giljerard/tia-sscs-pico-2021/schem/png/comp_cap.png

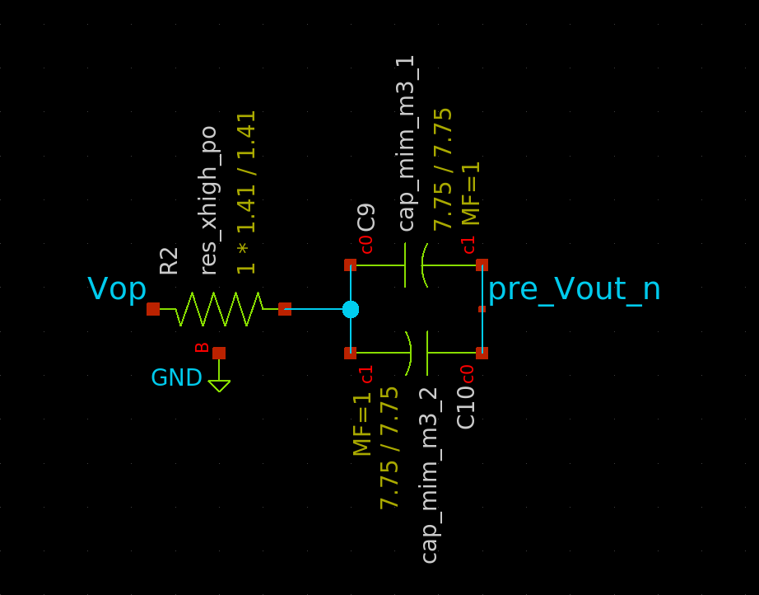
schem/png/comp_cap.png
