giljerard/tia-sscs-pico-2021/schem/png/Flattened-SSCS0.pdf

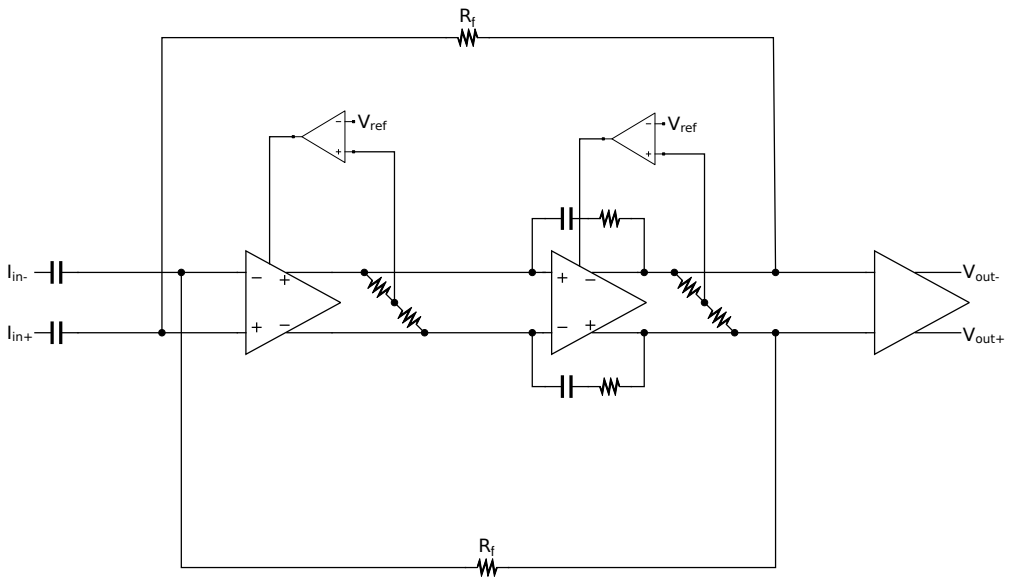
[picture p20: page 1]
+ Iin-; Rf Rf Vre; Vref f Iin+; Vout-
