giljerard/tia-sscs-pico-2021/pex/cmfb_pex.spice

* NGSPICE file created from cmfb.ext - technology: sky130A

.subckt cmfb_half VDD GND Vout res Vb3 Vin diode
X0 Vout Vin res GND sky130_fd_pr__nfet_01v8 ad=0p pd=0u as=0p ps=0u w=1e+07u l=200000u
X1 GND Vb3 res GND sky130_fd_pr__nfet_01v8 ad=0p pd=0u as=0p ps=0u w=1.3e+07u l=500000u
X2 Vout diode VDD VDD sky130_fd_pr__pfet_01v8 ad=0p pd=0u as=0p ps=0u w=1.05e+07u l=200000u
X3 res Vin Vout GND sky130_fd_pr__nfet_01v8 ad=0p pd=0u as=0p ps=0u w=1e+07u l=200000u
X4 res Vin Vout GND sky130_fd_pr__nfet_01v8 ad=0p pd=0u as=0p ps=0u w=1e+07u l=200000u
X5 Vout Vin res GND sky130_fd_pr__nfet_01v8 ad=0p pd=0u as=0p ps=0u w=1e+07u l=200000u
X6 GND Vb3 res GND sky130_fd_pr__nfet_01v8 ad=0p pd=0u as=0p ps=0u w=1.3e+07u l=500000u
X7 VDD diode Vout VDD sky130_fd_pr__pfet_01v8 ad=0p pd=0u as=0p ps=0u w=1.05e+07u l=200000u
X8 Vout Vin res GND sky130_fd_pr__nfet_01v8 ad=0p pd=0u as=0p ps=0u w=1e+07u l=200000u
X9 res Vin Vout GND sky130_fd_pr__nfet_01v8 ad=0p pd=0u as=0p ps=0u w=1e+07u l=200000u
X10 Vout diode VDD VDD sky130_fd_pr__pfet_01v8 ad=0p pd=0u as=0p ps=0u w=1.05e+07u l=200000u
X11 res Vin Vout GND sky130_fd_pr__nfet_01v8 ad=0p pd=0u as=0p ps=0u w=1e+07u l=200000u
X12 res Vin Vout GND sky130_fd_pr__nfet_01v8 ad=0p pd=0u as=0p ps=0u w=1e+07u l=200000u
X13 res Vb3 GND GND sky130_fd_pr__nfet_01v8 ad=0p pd=0u as=0p ps=0u w=1.3e+07u l=500000u
X14 res Vin Vout GND sky130_fd_pr__nfet_01v8 ad=0p pd=0u as=0p ps=0u w=1e+07u l=200000u
X15 Vout Vin res GND sky130_fd_pr__nfet_01v8 ad=0p pd=0u as=0p ps=0u w=1e+07u l=200000u
X16 VDD diode Vout VDD sky130_fd_pr__pfet_01v8 ad=0p pd=0u as=0p ps=0u w=1.05e+07u l=200000u
X17 res Vb3 GND GND sky130_fd_pr__nfet_01v8 ad=0p pd=0u as=0p ps=0u w=1.3e+07u l=500000u
X18 Vout Vin res GND sky130_fd_pr__nfet_01v8 ad=0p pd=0u as=0p ps=0u w=1e+07u l=200000u
X19 res Vin Vout GND sky130_fd_pr__nfet_01v8 ad=0p pd=0u as=0p ps=0u w=1e+07u l=200000u
X20 res Vin Vout GND sky130_fd_pr__nfet_01v8 ad=0p pd=0u as=0p ps=0u w=1e+07u l=200000u
X21 Vout Vin res GND sky130_fd_pr__nfet_01v8 ad=0p pd=0u as=0p ps=0u w=1e+07u l=200000u
X22 GND Vb3 res GND sky130_fd_pr__nfet_01v8 ad=0p pd=0u as=0p ps=0u w=1.3e+07u l=500000u
X23 Vout Vin res GND sky130_fd_pr__nfet_01v8 ad=0p pd=0u as=0p ps=0u w=1e+07u l=200000u
C0 Vout VDD 6.84fF
C1 res Vout 25.99fF
C2 Vb3 GND 3.81fF
C3 Vin GND 8.94fF
C4 res GND 7.55fF
C5 VDD GND 6.58fF
.ends

.subckt cmfb Vb3 Vref Vcm GND VDD Vcmfb
Xcmfb_half_1 VDD GND Vcmfb cmfb_half_1/res Vb3 Vref cmfb_half_0/Vout cmfb_half
Xcmfb_half_0 VDD GND cmfb_half_0/Vout cmfb_half_0/res Vb3 Vcm cmfb_half_0/Vout cmfb_half
X0 cmfb_half_1/res cmfb_half_0/res GND sky130_fd_pr__res_xhigh_po w=1.41e+06u l=1.41e+06u
C0 VDD GND 13.26fF
C1 Vcm GND 8.94fF
C2 cmfb_half_0/res GND 9.75fF
C3 Vb3 GND 7.49fF
C4 Vref GND 8.94fF
C5 cmfb_half_1/res GND 8.48fF
C6 cmfb_half_0/Vout GND 6.87fF
.ends
