giljerard/tia-sscs-pico-2021/pex/sf_pex.spice

* NGSPICE file created from sf.ext - technology: sky130A

.subckt sf_nup GND g d s
X0 s g d GND sky130_fd_pr__nfet_01v8_lvt ad=0p pd=0u as=0p ps=0u w=2.5e+07u l=320000u
X1 s g d GND sky130_fd_pr__nfet_01v8_lvt ad=0p pd=0u as=0p ps=0u w=2.5e+07u l=320000u
X2 d g s GND sky130_fd_pr__nfet_01v8_lvt ad=0p pd=0u as=0p ps=0u w=2.5e+07u l=320000u
X3 s g d GND sky130_fd_pr__nfet_01v8_lvt ad=0p pd=0u as=0p ps=0u w=2.5e+07u l=320000u
X4 s g d GND sky130_fd_pr__nfet_01v8_lvt ad=0p pd=0u as=0p ps=0u w=2.5e+07u l=320000u
X5 d g s GND sky130_fd_pr__nfet_01v8_lvt ad=0p pd=0u as=0p ps=0u w=2.5e+07u l=320000u
X6 s g d GND sky130_fd_pr__nfet_01v8_lvt ad=0p pd=0u as=0p ps=0u w=2.5e+07u l=320000u
X7 s g d GND sky130_fd_pr__nfet_01v8_lvt ad=0p pd=0u as=0p ps=0u w=2.5e+07u l=320000u
X8 d g s GND sky130_fd_pr__nfet_01v8_lvt ad=0p pd=0u as=0p ps=0u w=2.5e+07u l=320000u
X9 s g d GND sky130_fd_pr__nfet_01v8_lvt ad=0p pd=0u as=0p ps=0u w=2.5e+07u l=320000u
X10 s g d GND sky130_fd_pr__nfet_01v8_lvt ad=0p pd=0u as=0p ps=0u w=2.5e+07u l=320000u
X11 d g s GND sky130_fd_pr__nfet_01v8_lvt ad=0p pd=0u as=0p ps=0u w=2.5e+07u l=320000u
X12 d g s GND sky130_fd_pr__nfet_01v8_lvt ad=0p pd=0u as=0p ps=0u w=2.5e+07u l=320000u
X13 s g d GND sky130_fd_pr__nfet_01v8_lvt ad=0p pd=0u as=0p ps=0u w=2.5e+07u l=320000u
X14 d g s GND sky130_fd_pr__nfet_01v8_lvt ad=0p pd=0u as=0p ps=0u w=2.5e+07u l=320000u
X15 d g s GND sky130_fd_pr__nfet_01v8_lvt ad=0p pd=0u as=0p ps=0u w=2.5e+07u l=320000u
X16 d g s GND sky130_fd_pr__nfet_01v8_lvt ad=0p pd=0u as=0p ps=0u w=2.5e+07u l=320000u
X17 s g d GND sky130_fd_pr__nfet_01v8_lvt ad=0p pd=0u as=0p ps=0u w=2.5e+07u l=320000u
X18 s g d GND sky130_fd_pr__nfet_01v8_lvt ad=0p pd=0u as=0p ps=0u w=2.5e+07u l=320000u
X19 s g d GND sky130_fd_pr__nfet_01v8_lvt ad=0p pd=0u as=0p ps=0u w=2.5e+07u l=320000u
X20 d g s GND sky130_fd_pr__nfet_01v8_lvt ad=0p pd=0u as=0p ps=0u w=2.5e+07u l=320000u
X21 d g s GND sky130_fd_pr__nfet_01v8_lvt ad=0p pd=0u as=0p ps=0u w=2.5e+07u l=320000u
X22 s g d GND sky130_fd_pr__nfet_01v8_lvt ad=0p pd=0u as=0p ps=0u w=2.5e+07u l=320000u
X23 d g s GND sky130_fd_pr__nfet_01v8_lvt ad=0p pd=0u as=0p ps=0u w=2.5e+07u l=320000u
X24 d g s GND sky130_fd_pr__nfet_01v8_lvt ad=0p pd=0u as=0p ps=0u w=2.5e+07u l=320000u
X25 d g s GND sky130_fd_pr__nfet_01v8_lvt ad=0p pd=0u as=0p ps=0u w=2.5e+07u l=320000u
C0 g s 3.79fF
C1 s d 77.94fF
C2 g d 3.64fF
C3 d GND 5.93fF
C4 g GND 17.45fF
C5 s GND 14.64fF
.ends

.subckt sf_ndown g d s
X0 d g s s sky130_fd_pr__nfet_01v8 ad=0p pd=0u as=0p ps=0u w=2.5e+07u l=450000u
X1 d g s s sky130_fd_pr__nfet_01v8 ad=0p pd=0u as=0p ps=0u w=2.5e+07u l=450000u
X2 d g s s sky130_fd_pr__nfet_01v8 ad=0p pd=0u as=0p ps=0u w=2.5e+07u l=450000u
X3 d g s s sky130_fd_pr__nfet_01v8 ad=0p pd=0u as=0p ps=0u w=2.5e+07u l=450000u
X4 s g d s sky130_fd_pr__nfet_01v8 ad=0p pd=0u as=0p ps=0u w=2.5e+07u l=450000u
X5 d g s s sky130_fd_pr__nfet_01v8 ad=0p pd=0u as=0p ps=0u w=2.5e+07u l=450000u
X6 d g s s sky130_fd_pr__nfet_01v8 ad=0p pd=0u as=0p ps=0u w=2.5e+07u l=450000u
X7 s g d s sky130_fd_pr__nfet_01v8 ad=0p pd=0u as=0p ps=0u w=2.5e+07u l=450000u
X8 s g d s sky130_fd_pr__nfet_01v8 ad=0p pd=0u as=0p ps=0u w=2.5e+07u l=450000u
X9 s g d s sky130_fd_pr__nfet_01v8 ad=0p pd=0u as=0p ps=0u w=2.5e+07u l=450000u
X10 d g s s sky130_fd_pr__nfet_01v8 ad=0p pd=0u as=0p ps=0u w=2.5e+07u l=450000u
X11 d g s s sky130_fd_pr__nfet_01v8 ad=0p pd=0u as=0p ps=0u w=2.5e+07u l=450000u
X12 s g d s sky130_fd_pr__nfet_01v8 ad=0p pd=0u as=0p ps=0u w=2.5e+07u l=450000u
X13 s g d s sky130_fd_pr__nfet_01v8 ad=0p pd=0u as=0p ps=0u w=2.5e+07u l=450000u
X14 s g d s sky130_fd_pr__nfet_01v8 ad=0p pd=0u as=0p ps=0u w=2.5e+07u l=450000u
X15 d g s s sky130_fd_pr__nfet_01v8 ad=0p pd=0u as=0p ps=0u w=2.5e+07u l=450000u
X16 d g s s sky130_fd_pr__nfet_01v8 ad=0p pd=0u as=0p ps=0u w=2.5e+07u l=450000u
X17 d g s s sky130_fd_pr__nfet_01v8 ad=0p pd=0u as=0p ps=0u w=2.5e+07u l=450000u
X18 s g d s sky130_fd_pr__nfet_01v8 ad=0p pd=0u as=0p ps=0u w=2.5e+07u l=450000u
X19 s g d s sky130_fd_pr__nfet_01v8 ad=0p pd=0u as=0p ps=0u w=2.5e+07u l=450000u
X20 d g s s sky130_fd_pr__nfet_01v8 ad=0p pd=0u as=0p ps=0u w=2.5e+07u l=450000u
X21 d g s s sky130_fd_pr__nfet_01v8 ad=0p pd=0u as=0p ps=0u w=2.5e+07u l=450000u
X22 s g d s sky130_fd_pr__nfet_01v8 ad=0p pd=0u as=0p ps=0u w=2.5e+07u l=450000u
X23 s g d s sky130_fd_pr__nfet_01v8 ad=0p pd=0u as=0p ps=0u w=2.5e+07u l=450000u
X24 s g d s sky130_fd_pr__nfet_01v8 ad=0p pd=0u as=0p ps=0u w=2.5e+07u l=450000u
X25 s g d s sky130_fd_pr__nfet_01v8 ad=0p pd=0u as=0p ps=0u w=2.5e+07u l=450000u
C0 g d 5.11fF
C1 d s 66.44fF
C2 g s 21.60fF
.ends

.subckt sf_half Vout g_u g_d d s
Xsf_nup_0 s g_u d Vout sf_nup
Xsf_ndown_0 g_d Vout s sf_ndown
C0 g_d s 21.61fF
C1 d s 5.94fF
C2 g_u s 17.46fF
C3 Vout s 81.55fF
.ends

.subckt sf VDD Vin_n Vin_p Vout_p Vout_n sf_2 GND VDD#1
Xsf_half_0 Vout_p Vin_p sf_2 VDD#1 GND sf_half
Xsf_half_1 Vout_n Vin_n sf_2 VDD GND sf_half
C0 VDD GND 5.93fF
C1 Vin_n GND 17.47fF
C2 Vout_n GND 81.21fF
C3 sf_2 GND 47.24fF
C4 VDD#1 GND 5.93fF
C5 Vin_p GND 17.46fF
C6 Vout_p GND 81.15fF
.ends
