giljerard/tia-sscs-pico-2021/sims/core_stability.spice

**.subckt flattened_core_stability
VDD_source net1 GND 1.8
Vmeas net1 VDD 0
XM90 net3 net3 GND GND sky130_fd_pr__nfet_01v8 L=.15 W=50 nf=1 ad='int((nf+1)/2) * W/nf * 0.29' as='int((nf+2)/2) * W/nf * 0.29'
+ pd='2*int((nf+1)/2) * (W/nf + 0.29)' ps='2*int((nf+2)/2) * (W/nf + 0.29)' nrd='0.29 / W' nrs='0.29 / W'
+ sa=0 sb=0 sd=0 mult=1 m=1 
XM91 net2 net2 VDD_test VDD_test sky130_fd_pr__pfet_01v8 L=0.16 W=16 nf=1 ad='int((nf+1)/2) * W/nf * 0.29'
+ as='int((nf+2)/2) * W/nf * 0.29' pd='2*int((nf+1)/2) * (W/nf + 0.29)' ps='2*int((nf+2)/2) * (W/nf + 0.29)'
+ nrd='0.29 / W' nrs='0.29 / W' sa=0 sb=0 sd=0 mult=1 m=1 
I0 net2 GND 300u
I1 VDD_test net3 1m
XM1 net5 Vb1 net6 net6 sky130_fd_pr__nfet_01v8 L=.5 W=710 nf=8 ad='int((nf+1)/2) * W/nf * 0.29' as='int((nf+2)/2) * W/nf * 0.29'
+ pd='2*int((nf+1)/2) * (W/nf + 0.29)' ps='2*int((nf+2)/2) * (W/nf + 0.29)' nrd='0.29 / W' nrs='0.29 / W'
+ sa=0 sb=0 sd=0 mult=1 m=1 
VDD_test_source net4 GND 1.8
Vmeas2 net4 VDD_test 0
XM2 Vop Vinn net5 GND sky130_fd_pr__nfet_01v8 L=0.15 W=150 nf=4 ad='int((nf+1)/2) * W/nf * 0.29' as='int((nf+2)/2) * W/nf * 0.29'
+ pd='2*int((nf+1)/2) * (W/nf + 0.29)' ps='2*int((nf+2)/2) * (W/nf + 0.29)' nrd='0.29 / W' nrs='0.29 / W'
+ sa=0 sb=0 sd=0 mult=1 m=1 
XM3 Von Vinp net5 GND sky130_fd_pr__nfet_01v8 L=0.15 W=150 nf=4 ad='int((nf+1)/2) * W/nf * 0.29' as='int((nf+2)/2) * W/nf * 0.29'
+ pd='2*int((nf+1)/2) * (W/nf + 0.29)' ps='2*int((nf+2)/2) * (W/nf + 0.29)' nrd='0.29 / W' nrs='0.29 / W'
+ sa=0 sb=0 sd=0 mult=1 m=1 
XM5 Von Vcmfb1 VDD VDD sky130_fd_pr__pfet_01v8 L=0.18 W=112 nf=5 ad='int((nf+1)/2) * W/nf * 0.29' as='int((nf+2)/2) * W/nf * 0.29'
+ pd='2*int((nf+1)/2) * (W/nf + 0.29)' ps='2*int((nf+2)/2) * (W/nf + 0.29)' nrd='0.29 / W' nrs='0.29 / W'
+ sa=0 sb=0 sd=0 mult=1 m=1 
XM4 Vop Vcmfb1 net31 VDD sky130_fd_pr__pfet_01v8 L=0.18 W=112 nf=5 ad='int((nf+1)/2) * W/nf * 0.29' as='int((nf+2)/2) * W/nf * 0.29'
+ pd='2*int((nf+1)/2) * (W/nf + 0.29)' ps='2*int((nf+2)/2) * (W/nf + 0.29)' nrd='0.29 / W' nrs='0.29 / W'
+ sa=0 sb=0 sd=0 mult=1 m=1 
Vb2_source Vb2 GND .75
Vmeas1 VDD net31 0
XM6 net7 Vb1 net8 net8 sky130_fd_pr__nfet_01v8 L=.5 W=710 nf=8 ad='int((nf+1)/2) * W/nf * 0.29' as='int((nf+2)/2) * W/nf * 0.29'
+ pd='2*int((nf+1)/2) * (W/nf + 0.29)' ps='2*int((nf+2)/2) * (W/nf + 0.29)' nrd='0.29 / W' nrs='0.29 / W'
+ sa=0 sb=0 sd=0 mult=1 m=1 
XM7 pre_Vout_p Von net7 GND sky130_fd_pr__nfet_01v8 L=0.15 W=150 nf=4 ad='int((nf+1)/2) * W/nf * 0.29'
+ as='int((nf+2)/2) * W/nf * 0.29' pd='2*int((nf+1)/2) * (W/nf + 0.29)' ps='2*int((nf+2)/2) * (W/nf + 0.29)'
+ nrd='0.29 / W' nrs='0.29 / W' sa=0 sb=0 sd=0 mult=1 m=1 
XM8 pre_Vout_n Vop net7 GND sky130_fd_pr__nfet_01v8 L=0.15 W=150 nf=4 ad='int((nf+1)/2) * W/nf * 0.29'
+ as='int((nf+2)/2) * W/nf * 0.29' pd='2*int((nf+1)/2) * (W/nf + 0.29)' ps='2*int((nf+2)/2) * (W/nf + 0.29)'
+ nrd='0.29 / W' nrs='0.29 / W' sa=0 sb=0 sd=0 mult=1 m=1 
XM9 pre_Vout_n Vcmfb2 VDD VDD sky130_fd_pr__pfet_01v8 L=0.18 W=112 nf=8 ad='int((nf+1)/2) * W/nf * 0.29'
+ as='int((nf+2)/2) * W/nf * 0.29' pd='2*int((nf+1)/2) * (W/nf + 0.29)' ps='2*int((nf+2)/2) * (W/nf + 0.29)'
+ nrd='0.29 / W' nrs='0.29 / W' sa=0 sb=0 sd=0 mult=1 m=1 
XM10 pre_Vout_p Vcmfb2 net32 VDD sky130_fd_pr__pfet_01v8 L=0.18 W=112 nf=8 ad='int((nf+1)/2) * W/nf * 0.29'
+ as='int((nf+2)/2) * W/nf * 0.29' pd='2*int((nf+1)/2) * (W/nf + 0.29)' ps='2*int((nf+2)/2) * (W/nf + 0.29)'
+ nrd='0.29 / W' nrs='0.29 / W' sa=0 sb=0 sd=0 mult=1 m=1 
Vmeas4 VDD net32 0
Vmeas5 net9 GND 0
VDD_dummy_source net10 GND 1.8
Vmeas6 net10 VDD_dummy 0
XR6 Vfbn pre_Vout_n GND sky130_fd_pr__res_xhigh_po_1p41 W=1.41 L=53 mult=1 m=1
XR1 pre_Vout_p Vfbp GND sky130_fd_pr__res_xhigh_po_1p41 W=1.41 L=53 mult=1 m=1
XM16 Vout_p Vb3 net11 net11 sky130_fd_pr__nfet_01v8 L=.45 W=650 nf=8 ad='int((nf+1)/2) * W/nf * 0.29'
+ as='int((nf+2)/2) * W/nf * 0.29' pd='2*int((nf+1)/2) * (W/nf + 0.29)' ps='2*int((nf+2)/2) * (W/nf + 0.29)'
+ nrd='0.29 / W' nrs='0.29 / W' sa=0 sb=0 sd=0 mult=1 m=1 
XM19 Vout_n Vb3 GND GND sky130_fd_pr__nfet_01v8 L=.45 W=650 nf=8 ad='int((nf+1)/2) * W/nf * 0.29' as='int((nf+2)/2) * W/nf * 0.29'
+ pd='2*int((nf+1)/2) * (W/nf + 0.29)' ps='2*int((nf+2)/2) * (W/nf + 0.29)' nrd='0.29 / W' nrs='0.29 / W'
+ sa=0 sb=0 sd=0 mult=1 m=1 
Vmeas8 net11 GND 0
XM17 VDD pre_Vout_p Vout_p GND sky130_fd_pr__nfet_01v8_lvt L=0.32 W=650 nf=8 ad='int((nf+1)/2) * W/nf * 0.29'
+ as='int((nf+2)/2) * W/nf * 0.29' pd='2*int((nf+1)/2) * (W/nf + 0.29)' ps='2*int((nf+2)/2) * (W/nf + 0.29)'
+ nrd='0.29 / W' nrs='0.29 / W' sa=0 sb=0 sd=0 mult=1 m=1 
XM18 VDD pre_Vout_n Vout_n GND sky130_fd_pr__nfet_01v8_lvt L=0.32 W=650 nf=8 ad='int((nf+1)/2) * W/nf * 0.29'
+ as='int((nf+2)/2) * W/nf * 0.29' pd='2*int((nf+1)/2) * (W/nf + 0.29)' ps='2*int((nf+2)/2) * (W/nf + 0.29)'
+ nrd='0.29 / W' nrs='0.29 / W' sa=0 sb=0 sd=0 mult=1 m=1 
C5 GND Vout_n 20p m=1
C6 GND Vout_p 20p m=1
Vmeas9 net8 GND 0
Vmeas10 net6 GND 0
XM24 Vop Vb2 net12 net12 sky130_fd_pr__pfet_01v8 L=0.18 W=448 nf=15 ad='int((nf+1)/2) * W/nf * 0.29'
+ as='int((nf+2)/2) * W/nf * 0.29' pd='2*int((nf+1)/2) * (W/nf + 0.29)' ps='2*int((nf+2)/2) * (W/nf + 0.29)'
+ nrd='0.29 / W' nrs='0.29 / W' sa=0 sb=0 sd=0 mult=1 m=1 
XM25 Von Vb2 VDD VDD sky130_fd_pr__pfet_01v8 L=0.18 W=448 nf=15 ad='int((nf+1)/2) * W/nf * 0.29' as='int((nf+2)/2) * W/nf * 0.29'
+ pd='2*int((nf+1)/2) * (W/nf + 0.29)' ps='2*int((nf+2)/2) * (W/nf + 0.29)' nrd='0.29 / W' nrs='0.29 / W'
+ sa=0 sb=0 sd=0 mult=1 m=1 
Vmeas12 VDD net12 0
XM27 net13 net13 net14 net14 sky130_fd_pr__nfet_01v8 L=.5 W=3.6 nf=1 ad='int((nf+1)/2) * W/nf * 0.29'
+ as='int((nf+2)/2) * W/nf * 0.29' pd='2*int((nf+1)/2) * (W/nf + 0.29)' ps='2*int((nf+2)/2) * (W/nf + 0.29)'
+ nrd='0.29 / W' nrs='0.29 / W' sa=0 sb=0 sd=0 mult=1 m=1 
Vmeas14 net14 GND 0
R9 VDD net13 26k ac=26k m=1
C2 net16 Von 250f m=1
C1 net15 Vop 250f m=1
XR3 Vcm2 pre_Vout_p GND sky130_fd_pr__res_xhigh_po_1p41 W=1.41 L=35 mult=1 m=1
XR5 pre_Vout_n Vcm2 GND sky130_fd_pr__res_xhigh_po_1p41 W=1.41 L=35 mult=1 m=1
XR4 pre_Vout_n net15 GND sky130_fd_pr__res_xhigh_po_1p41 W=1.41 L=1.41 mult=1 m=1
XR10 pre_Vout_p net16 GND sky130_fd_pr__res_xhigh_po_1p41 W=1.41 L=1.41 mult=1 m=1
XR2 net9 VDD_dummy GND sky130_fd_pr__res_xhigh_po_0p35 W=0.35 L=175 mult=5 m=5
XR11 Vb1 net13 GND sky130_fd_pr__res_xhigh_po_0p35 W=0.35 L=175 mult=1 m=1
C9 GND Vb1 1p m=1
XM28 net17 net17 net18 net18 sky130_fd_pr__nfet_01v8 L=.45 W=4 nf=1 ad='int((nf+1)/2) * W/nf * 0.29'
+ as='int((nf+2)/2) * W/nf * 0.29' pd='2*int((nf+1)/2) * (W/nf + 0.29)' ps='2*int((nf+2)/2) * (W/nf + 0.29)'
+ nrd='0.29 / W' nrs='0.29 / W' sa=0 sb=0 sd=0 mult=1 m=1 
Vmeas15 net18 GND 0
R13 VDD net17 26k ac=26k m=1
XR14 Vb3 net17 GND sky130_fd_pr__res_xhigh_po_0p35 W=0.35 L=175 mult=1 m=1
C10 GND Vb3 1p m=1
XM29 net19 net19 net20 net20 sky130_fd_pr__nfet_01v8 L=.5 W=10 nf=1 ad='int((nf+1)/2) * W/nf * 0.29'
+ as='int((nf+2)/2) * W/nf * 0.29' pd='2*int((nf+1)/2) * (W/nf + 0.29)' ps='2*int((nf+2)/2) * (W/nf + 0.29)'
+ nrd='0.29 / W' nrs='0.29 / W' sa=0 sb=0 sd=0 mult=1 m=1 
Vmeas16 net20 GND 0
R15 VDD net19 26k ac=26k m=1
XR16 Vb4 net19 GND sky130_fd_pr__res_xhigh_po_0p35 W=0.35 L=175 mult=1 m=1
C11 GND Vb4 1p m=1
XR17 Vcm1 Vop GND sky130_fd_pr__res_xhigh_po_1p41 W=1.41 L=35 mult=1 m=1
XR18 Von Vcm1 GND sky130_fd_pr__res_xhigh_po_1p41 W=1.41 L=35 mult=1 m=1
XM30 pre_Vout_n Vb2 VDD VDD sky130_fd_pr__pfet_01v8 L=0.18 W=448 nf=15 ad='int((nf+1)/2) * W/nf * 0.29'
+ as='int((nf+2)/2) * W/nf * 0.29' pd='2*int((nf+1)/2) * (W/nf + 0.29)' ps='2*int((nf+2)/2) * (W/nf + 0.29)'
+ nrd='0.29 / W' nrs='0.29 / W' sa=0 sb=0 sd=0 mult=1 m=1 
XM31 pre_Vout_p Vb2 VDD VDD sky130_fd_pr__pfet_01v8 L=0.18 W=448 nf=15 ad='int((nf+1)/2) * W/nf * 0.29'
+ as='int((nf+2)/2) * W/nf * 0.29' pd='2*int((nf+1)/2) * (W/nf + 0.29)' ps='2*int((nf+2)/2) * (W/nf + 0.29)'
+ nrd='0.29 / W' nrs='0.29 / W' sa=0 sb=0 sd=0 mult=1 m=1 
XM11 Vcmfb1 Vb5 net21 GND sky130_fd_pr__nfet_01v8 L=0.20 W=150 nf=2 ad='int((nf+1)/2) * W/nf * 0.29'
+ as='int((nf+2)/2) * W/nf * 0.29' pd='2*int((nf+1)/2) * (W/nf + 0.29)' ps='2*int((nf+2)/2) * (W/nf + 0.29)'
+ nrd='0.29 / W' nrs='0.29 / W' sa=0 sb=0 sd=0 mult=1 m=1 
XM12 net23 Vcm1 net22 GND sky130_fd_pr__nfet_01v8 L=0.20 W=150 nf=2 ad='int((nf+1)/2) * W/nf * 0.29'
+ as='int((nf+2)/2) * W/nf * 0.29' pd='2*int((nf+1)/2) * (W/nf + 0.29)' ps='2*int((nf+2)/2) * (W/nf + 0.29)'
+ nrd='0.29 / W' nrs='0.29 / W' sa=0 sb=0 sd=0 mult=1 m=1 
XM13 net23 net23 VDD VDD sky130_fd_pr__pfet_01v8 L=0.2 W=42 nf=1 ad='int((nf+1)/2) * W/nf * 0.29' as='int((nf+2)/2) * W/nf * 0.29'
+ pd='2*int((nf+1)/2) * (W/nf + 0.29)' ps='2*int((nf+2)/2) * (W/nf + 0.29)' nrd='0.29 / W' nrs='0.29 / W'
+ sa=0 sb=0 sd=0 mult=1 m=1 
XM14 Vcmfb1 net23 net33 VDD sky130_fd_pr__pfet_01v8 L=0.2 W=42 nf=1 ad='int((nf+1)/2) * W/nf * 0.29'
+ as='int((nf+2)/2) * W/nf * 0.29' pd='2*int((nf+1)/2) * (W/nf + 0.29)' ps='2*int((nf+2)/2) * (W/nf + 0.29)'
+ nrd='0.29 / W' nrs='0.29 / W' sa=0 sb=0 sd=0 mult=1 m=1 
Vmeas19 VDD net33 0
XM15 net21 Vb4 net24 net24 sky130_fd_pr__nfet_01v8 L=.5 W=65 nf=1 ad='int((nf+1)/2) * W/nf * 0.29' as='int((nf+2)/2) * W/nf * 0.29'
+ pd='2*int((nf+1)/2) * (W/nf + 0.29)' ps='2*int((nf+2)/2) * (W/nf + 0.29)' nrd='0.29 / W' nrs='0.29 / W'
+ sa=0 sb=0 sd=0 mult=1 m=1 
Vmeas21 net24 GND 0
XM26 net22 Vb4 net25 net25 sky130_fd_pr__nfet_01v8 L=.5 W=65 nf=1 ad='int((nf+1)/2) * W/nf * 0.29' as='int((nf+2)/2) * W/nf * 0.29'
+ pd='2*int((nf+1)/2) * (W/nf + 0.29)' ps='2*int((nf+2)/2) * (W/nf + 0.29)' nrd='0.29 / W' nrs='0.29 / W'
+ sa=0 sb=0 sd=0 mult=1 m=1 
Vmeas22 net25 GND 0
XR20 net22 net21 GND sky130_fd_pr__res_xhigh_po_1p41 W=1.41 L=1.41 mult=1 m=1
XM34 Vcmfb2 Vb5 net26 GND sky130_fd_pr__nfet_01v8 L=0.20 W=150 nf=2 ad='int((nf+1)/2) * W/nf * 0.29'
+ as='int((nf+2)/2) * W/nf * 0.29' pd='2*int((nf+1)/2) * (W/nf + 0.29)' ps='2*int((nf+2)/2) * (W/nf + 0.29)'
+ nrd='0.29 / W' nrs='0.29 / W' sa=0 sb=0 sd=0 mult=1 m=1 
XM35 net28 Vcm2 net27 GND sky130_fd_pr__nfet_01v8 L=0.20 W=150 nf=2 ad='int((nf+1)/2) * W/nf * 0.29'
+ as='int((nf+2)/2) * W/nf * 0.29' pd='2*int((nf+1)/2) * (W/nf + 0.29)' ps='2*int((nf+2)/2) * (W/nf + 0.29)'
+ nrd='0.29 / W' nrs='0.29 / W' sa=0 sb=0 sd=0 mult=1 m=1 
XM36 net28 net28 VDD VDD sky130_fd_pr__pfet_01v8 L=0.2 W=42 nf=1 ad='int((nf+1)/2) * W/nf * 0.29' as='int((nf+2)/2) * W/nf * 0.29'
+ pd='2*int((nf+1)/2) * (W/nf + 0.29)' ps='2*int((nf+2)/2) * (W/nf + 0.29)' nrd='0.29 / W' nrs='0.29 / W'
+ sa=0 sb=0 sd=0 mult=1 m=1 
XM37 Vcmfb2 net28 net34 VDD sky130_fd_pr__pfet_01v8 L=0.2 W=42 nf=1 ad='int((nf+1)/2) * W/nf * 0.29'
+ as='int((nf+2)/2) * W/nf * 0.29' pd='2*int((nf+1)/2) * (W/nf + 0.29)' ps='2*int((nf+2)/2) * (W/nf + 0.29)'
+ nrd='0.29 / W' nrs='0.29 / W' sa=0 sb=0 sd=0 mult=1 m=1 
Vmeas3 VDD net34 0
XM38 net26 Vb4 net29 net29 sky130_fd_pr__nfet_01v8 L=.5 W=65 nf=1 ad='int((nf+1)/2) * W/nf * 0.29' as='int((nf+2)/2) * W/nf * 0.29'
+ pd='2*int((nf+1)/2) * (W/nf + 0.29)' ps='2*int((nf+2)/2) * (W/nf + 0.29)' nrd='0.29 / W' nrs='0.29 / W'
+ sa=0 sb=0 sd=0 mult=1 m=1 
Vmeas7 net29 GND 0
XM39 net27 Vb4 net30 net30 sky130_fd_pr__nfet_01v8 L=.5 W=65 nf=1 ad='int((nf+1)/2) * W/nf * 0.29' as='int((nf+2)/2) * W/nf * 0.29'
+ pd='2*int((nf+1)/2) * (W/nf + 0.29)' ps='2*int((nf+2)/2) * (W/nf + 0.29)' nrd='0.29 / W' nrs='0.29 / W'
+ sa=0 sb=0 sd=0 mult=1 m=1 
Vmeas13 net30 GND 0
XR12 net27 net26 GND sky130_fd_pr__res_xhigh_po_1p41 W=1.41 L=1.41 mult=1 m=1
Vb5 Vb5 GND 1.3
C12 Vfbn GND 2.7p m=1
C13 Vfbp GND 2.7p m=1
Vb1 Vinp GND sin(1.303,.5u,1k) ac 1 0
Vb2 Vinn GND sin(1.303,-.5u,1k)
C4 Vcmfb1 GND 4.5p m=1
C3 Vcmfb2 GND 4.5p m=1
**** begin user architecture code

.include ~/Google-Skywater/skywater-pdk/libraries/sky130_fd_pr_ngspice/latest/cells/nfet_01v8/sky130_fd_pr__nfet_01v8__tt.corner.spice
.include ~/Google-Skywater/skywater-pdk/libraries/sky130_fd_pr_ngspice/latest/cells/pfet_01v8/sky130_fd_pr__pfet_01v8__tt.corner.spice
.include ~/Google-Skywater/skywater-pdk/libraries/sky130_fd_pr_ngspice/latest/cells/nfet_01v8_lvt/sky130_fd_pr__nfet_01v8_lvt__tt.corner.spice
*.include ~/Google-Skywater/skywater-pdk/libraries/sky130_fd_pr_ngspice/latest/cells/nfet_03v3_nvt/sky130_fd_pr__nfet_03v3_nvt__tt.corner.spice
*.include ~/Google-Skywater/skywater-pdk/libraries/sky130_fd_pr_ngspice/latest/cells/nfet_05v0_nvt/sky130_fd_pr__nfet_05v0_nvt__tt.corner.spice
*.include ~/Google-Skywater/skywater-pdk/libraries/sky130_fd_pr_ngspice/latest/cells/esd_nfet_01v8/sky130_fd_pr__esd_nfet_01v8__tt.corner.spice
*.include ~/Google-Skywater/skywater-pdk/libraries/sky130_fd_pr_ngspice/latest/cells/pfet_01v8_lvt/sky130_fd_pr__pfet_01v8_lvt__tt.corner.spice
*.include ~/Google-Skywater/skywater-pdk/libraries/sky130_fd_pr_ngspice/latest/cells/pfet_01v8_hvt/sky130_fd_pr__pfet_01v8_hvt__tt.corner.spice
*.include ~/Google-Skywater/skywater-pdk/libraries/sky130_fd_pr_ngspice/latest/models/corners/tt/nonfet.spice
* Mismatch parameters
.include ~/Google-Skywater/skywater-pdk/libraries/sky130_fd_pr_ngspice/latest/cells/nfet_01v8/sky130_fd_pr__nfet_01v8__mismatch.corner.spice
.include ~/Google-Skywater/skywater-pdk/libraries/sky130_fd_pr_ngspice/latest/cells/pfet_01v8/sky130_fd_pr__pfet_01v8__mismatch.corner.spice
.include ~/Google-Skywater/skywater-pdk/libraries/sky130_fd_pr_ngspice/latest/cells/nfet_01v8_lvt/sky130_fd_pr__nfet_01v8_lvt__mismatch.corner.spice
*.include ~/Google-Skywater/skywater-pdk/libraries/sky130_fd_pr_ngspice/latest/cells/pfet_01v8_lvt/sky130_fd_pr__pfet_01v8_lvt__mismatch.corner.spice
*.include ~/Google-Skywater/skywater-pdk/libraries/sky130_fd_pr_ngspice/latest/cells/pfet_01v8_hvt/sky130_fd_pr__pfet_01v8_hvt__mismatch.corner.spice
*.include ~/Google-Skywater/skywater-pdk/libraries/sky130_fd_pr_ngspice/latest/cells/nfet_g5v0d10v5/sky130_fd_pr__nfet_g5v0d10v5__mismatch.corner.spice
*.include ~/Google-Skywater/skywater-pdk/libraries/sky130_fd_pr_ngspice/latest/cells/pfet_g5v0d10v5/sky130_fd_pr__pfet_g5v0d10v5__mismatch.corner.spice
*.include ~/Google-Skywater/skywater-pdk/libraries/sky130_fd_pr_ngspice/latest/cells/nfet_05v0_nvt/sky130_fd_pr__nfet_05v0_nvt__mismatch.corner.spice
*.include ~/Google-Skywater/skywater-pdk/libraries/sky130_fd_pr_ngspice/latest/cells/nfet_03v3_nvt/sky130_fd_pr__nfet_03v3_nvt__mismatch.corner.spice
* Resistor~/Google-Skywater/skywater-pdk/libraries/sky130_fd_pr_ngspice/latest/Capacitor
.include ~/Google-Skywater/skywater-pdk/libraries/sky130_fd_pr_ngspice/latest/models/r+c/res_typical__cap_typical.spice
.include ~/Google-Skywater/skywater-pdk/libraries/sky130_fd_pr_ngspice/latest/models/r+c/res_typical__cap_typical__lin.spice
* Special cells
*.include ~/Google-Skywater/skywater-pdk/libraries/sky130_fd_pr_ngspice/latest/models/corners/tt/specialized_cells.spice
* All models
.include ~/Google-Skywater/skywater-pdk/libraries/sky130_fd_pr_ngspice/latest/models/all.spice
* Corner
*.include ~/Google-Skywater/skywater-pdk/libraries/sky130_fd_pr_ngspice/latest/models/corners/tt/rf.spice


.option savecurrents
.control
save all
*NFET

save @m.xm90.msky130_fd_pr__nfet_01v8[vds] @m.xm90.msky130_fd_pr__nfet_01v8[gm]
+ @m.xm90.msky130_fd_pr__nfet_01v8[vth] @m.xm90.msky130_fd_pr__nfet_01v8[vgs] @m.xm90.msky130_fd_pr__nfet_01v8[id]
+ @m.xm90.msky130_fd_pr__nfet_01v8[gds] @m.xm90.msky130_fd_pr__nfet_01v8[cgg] @m.xm90.msky130_fd_pr__nfet_01v8[cgs]
+ @m.xm90.msky130_fd_pr__nfet_01v8[cgd] @m.xm90.msky130_fd_pr__nfet_01v8[cgb] @m.xm90.msky130_fd_pr__nfet_01v8[cdg]
+ @m.xm90.msky130_fd_pr__nfet_01v8[cds] @m.xm90.msky130_fd_pr__nfet_01v8[cdd] @m.xm90.msky130_fd_pr__nfet_01v8[cdb]
+ @m.xm90.msky130_fd_pr__nfet_01v8[csg] @m.xm90.msky130_fd_pr__nfet_01v8[css] @m.xm90.msky130_fd_pr__nfet_01v8[csd]
+ @m.xm90.msky130_fd_pr__nfet_01v8[csb] @m.xm90.msky130_fd_pr__nfet_01v8[cbg] @m.xm90.msky130_fd_pr__nfet_01v8[cbs]
+ @m.xm90.msky130_fd_pr__nfet_01v8[cbd] @m.xm90.msky130_fd_pr__nfet_01v8[cbb]
save @m.xm1.msky130_fd_pr__nfet_01v8[vds] @m.xm1.msky130_fd_pr__nfet_01v8[gm]
+ @m.xm1.msky130_fd_pr__nfet_01v8[vth] @m.xm1.msky130_fd_pr__nfet_01v8[vgs] @m.xm1.msky130_fd_pr__nfet_01v8[id]
+ @m.xm1.msky130_fd_pr__nfet_01v8[gds] @m.xm1.msky130_fd_pr__nfet_01v8[cgg] @m.xm1.msky130_fd_pr__nfet_01v8[cgs]
+ @m.xm1.msky130_fd_pr__nfet_01v8[cgd] @m.xm1.msky130_fd_pr__nfet_01v8[cgb] @m.xm1.msky130_fd_pr__nfet_01v8[cdg]
+ @m.xm1.msky130_fd_pr__nfet_01v8[cds] @m.xm1.msky130_fd_pr__nfet_01v8[cdd] @m.xm1.msky130_fd_pr__nfet_01v8[cdb]
+ @m.xm1.msky130_fd_pr__nfet_01v8[csg] @m.xm1.msky130_fd_pr__nfet_01v8[css] @m.xm1.msky130_fd_pr__nfet_01v8[csd]
+ @m.xm1.msky130_fd_pr__nfet_01v8[csb] @m.xm1.msky130_fd_pr__nfet_01v8[cbg] @m.xm1.msky130_fd_pr__nfet_01v8[cbs]
+ @m.xm1.msky130_fd_pr__nfet_01v8[cbd] @m.xm1.msky130_fd_pr__nfet_01v8[cbb]
save @m.xm2.msky130_fd_pr__nfet_01v8[vds] @m.xm2.msky130_fd_pr__nfet_01v8[gm]
+ @m.xm2.msky130_fd_pr__nfet_01v8[vth] @m.xm2.msky130_fd_pr__nfet_01v8[vgs] @m.xm2.msky130_fd_pr__nfet_01v8[id]
+ @m.xm2.msky130_fd_pr__nfet_01v8[gds] @m.xm2.msky130_fd_pr__nfet_01v8[cgg] @m.xm2.msky130_fd_pr__nfet_01v8[cgs]
+ @m.xm2.msky130_fd_pr__nfet_01v8[cgd] @m.xm2.msky130_fd_pr__nfet_01v8[cgb] @m.xm2.msky130_fd_pr__nfet_01v8[cdg]
+ @m.xm2.msky130_fd_pr__nfet_01v8[cds] @m.xm2.msky130_fd_pr__nfet_01v8[cdd] @m.xm2.msky130_fd_pr__nfet_01v8[cdb]
+ @m.xm2.msky130_fd_pr__nfet_01v8[csg] @m.xm2.msky130_fd_pr__nfet_01v8[css] @m.xm2.msky130_fd_pr__nfet_01v8[csd]
+ @m.xm2.msky130_fd_pr__nfet_01v8[csb] @m.xm2.msky130_fd_pr__nfet_01v8[cbg] @m.xm2.msky130_fd_pr__nfet_01v8[cbs]
+ @m.xm2.msky130_fd_pr__nfet_01v8[cbd] @m.xm2.msky130_fd_pr__nfet_01v8[cbb]
save @m.xm3.msky130_fd_pr__nfet_01v8[vds] @m.xm3.msky130_fd_pr__nfet_01v8[gm]
+ @m.xm3.msky130_fd_pr__nfet_01v8[vth] @m.xm3.msky130_fd_pr__nfet_01v8[vgs] @m.xm3.msky130_fd_pr__nfet_01v8[id]
+ @m.xm3.msky130_fd_pr__nfet_01v8[gds] @m.xm3.msky130_fd_pr__nfet_01v8[cgg] @m.xm3.msky130_fd_pr__nfet_01v8[cgs]
+ @m.xm3.msky130_fd_pr__nfet_01v8[cgd] @m.xm3.msky130_fd_pr__nfet_01v8[cgb] @m.xm3.msky130_fd_pr__nfet_01v8[cdg]
+ @m.xm3.msky130_fd_pr__nfet_01v8[cds] @m.xm3.msky130_fd_pr__nfet_01v8[cdd] @m.xm3.msky130_fd_pr__nfet_01v8[cdb]
+ @m.xm3.msky130_fd_pr__nfet_01v8[csg] @m.xm3.msky130_fd_pr__nfet_01v8[css] @m.xm3.msky130_fd_pr__nfet_01v8[csd]
+ @m.xm3.msky130_fd_pr__nfet_01v8[csb] @m.xm3.msky130_fd_pr__nfet_01v8[cbg] @m.xm3.msky130_fd_pr__nfet_01v8[cbs]
+ @m.xm3.msky130_fd_pr__nfet_01v8[cbd] @m.xm3.msky130_fd_pr__nfet_01v8[cbb]
save @m.xm6.msky130_fd_pr__nfet_01v8[vds] @m.xm6.msky130_fd_pr__nfet_01v8[gm]
+ @m.xm6.msky130_fd_pr__nfet_01v8[vth] @m.xm6.msky130_fd_pr__nfet_01v8[vgs] @m.xm6.msky130_fd_pr__nfet_01v8[id]
+ @m.xm6.msky130_fd_pr__nfet_01v8[gds] @m.xm6.msky130_fd_pr__nfet_01v8[cgg] @m.xm6.msky130_fd_pr__nfet_01v8[cgs]
+ @m.xm6.msky130_fd_pr__nfet_01v8[cgd] @m.xm6.msky130_fd_pr__nfet_01v8[cgb] @m.xm6.msky130_fd_pr__nfet_01v8[cdg]
+ @m.xm6.msky130_fd_pr__nfet_01v8[cds] @m.xm6.msky130_fd_pr__nfet_01v8[cdd] @m.xm6.msky130_fd_pr__nfet_01v8[cdb]
+ @m.xm6.msky130_fd_pr__nfet_01v8[csg] @m.xm6.msky130_fd_pr__nfet_01v8[css] @m.xm6.msky130_fd_pr__nfet_01v8[csd]
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
+ @m.xm30.msky130_fd_pr__nfet_01v8[vth] @m.xm30.msky130_fd_pr__nfet_01v8[vgs] @m.xm30.msky130_fd_pr__nfet_01v8[id]
+ @m.xm30.msky130_fd_pr__nfet_01v8[gds] @m.xm30.msky130_fd_pr__nfet_01v8[cgg] @m.xm30.msky130_fd_pr__nfet_01v8[cgs]
+ @m.xm30.msky130_fd_pr__nfet_01v8[cgd] @m.xm30.msky130_fd_pr__nfet_01v8[cgb] @m.xm30.msky130_fd_pr__nfet_01v8[cdg]
+ @m.xm30.msky130_fd_pr__nfet_01v8[cds] @m.xm30.msky130_fd_pr__nfet_01v8[cdd] @m.xm30.msky130_fd_pr__nfet_01v8[cdb]
+ @m.xm30.msky130_fd_pr__nfet_01v8[csg] @m.xm30.msky130_fd_pr__nfet_01v8[css] @m.xm30.msky130_fd_pr__nfet_01v8[csd]
+ @m.xm30.msky130_fd_pr__nfet_01v8[csb] @m.xm30.msky130_fd_pr__nfet_01v8[cbg] @m.xm30.msky130_fd_pr__nfet_01v8[cbs]
+ @m.xm30.msky130_fd_pr__nfet_01v8[cbd] @m.xm30.msky130_fd_pr__nfet_01v8[cbb]
save @m.xm26.msky130_fd_pr__nfet_01v8[vds] @m.xm26.msky130_fd_pr__nfet_01v8[gm]
+ @m.xm26.msky130_fd_pr__nfet_01v8[vth] @m.xm26.msky130_fd_pr__nfet_01v8[vgs] @m.xm26.msky130_fd_pr__nfet_01v8[id]
+ @m.xm26.msky130_fd_pr__nfet_01v8[gds] @m.xm26.msky130_fd_pr__nfet_01v8[cgg] @m.xm26.msky130_fd_pr__nfet_01v8[cgs]
+ @m.xm26.msky130_fd_pr__nfet_01v8[cgd] @m.xm26.msky130_fd_pr__nfet_01v8[cgb] @m.xm26.msky130_fd_pr__nfet_01v8[cdg]
+ @m.xm26.msky130_fd_pr__nfet_01v8[cds] @m.xm26.msky130_fd_pr__nfet_01v8[cdd] @m.xm26.msky130_fd_pr__nfet_01v8[cdb]
+ @m.xm26.msky130_fd_pr__nfet_01v8[csg] @m.xm26.msky130_fd_pr__nfet_01v8[css] @m.xm26.msky130_fd_pr__nfet_01v8[csd]
+ @m.xm26.msky130_fd_pr__nfet_01v8[csb] @m.xm26.msky130_fd_pr__nfet_01v8[cbg] @m.xm26.msky130_fd_pr__nfet_01v8[cbs]
+ @m.xm26.msky130_fd_pr__nfet_01v8[cbd] @m.xm26.msky130_fd_pr__nfet_01v8[cbb]
save @m.xm27.msky130_fd_pr__nfet_01v8[vds] @m.xm27.msky130_fd_pr__nfet_01v8[gm]
+ @m.xm27.msky130_fd_pr__nfet_01v8[vth] @m.xm27.msky130_fd_pr__nfet_01v8[vgs] @m.xm27.msky130_fd_pr__nfet_01v8[id]
+ @m.xm27.msky130_fd_pr__nfet_01v8[gds] @m.xm27.msky130_fd_pr__nfet_01v8[cgg] @m.xm27.msky130_fd_pr__nfet_01v8[cgs]
+ @m.xm27.msky130_fd_pr__nfet_01v8[cgd] @m.xm27.msky130_fd_pr__nfet_01v8[cgb] @m.xm27.msky130_fd_pr__nfet_01v8[cdg]
+ @m.xm27.msky130_fd_pr__nfet_01v8[cds] @m.xm27.msky130_fd_pr__nfet_01v8[cdd] @m.xm27.msky130_fd_pr__nfet_01v8[cdb]
+ @m.xm27.msky130_fd_pr__nfet_01v8[csg] @m.xm27.msky130_fd_pr__nfet_01v8[css] @m.xm27.msky130_fd_pr__nfet_01v8[csd]
+ @m.xm27.msky130_fd_pr__nfet_01v8[csb] @m.xm27.msky130_fd_pr__nfet_01v8[cbg] @m.xm27.msky130_fd_pr__nfet_01v8[cbs]
+ @m.xm27.msky130_fd_pr__nfet_01v8[cbd] @m.xm27.msky130_fd_pr__nfet_01v8[cbb]

*PFET
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
