giljerard/tia-sscs-pico-2021/lvs/mirror_4/mirror_4_mag.spice

* NGSPICE file created from mirror_4.ext - technology: sky130A

.subckt mirror_4 GND Vb4_ Vb4
X0 a_1900_980# a_5540_1300# GND sky130_fd_pr__res_xhigh_po w=350000u l=1.6e+07u
X1 Vb4 GND sky130_fd_pr__cap_mim_m3_1 l=1.58e+07u w=1.58e+07u
X2 a_1900_2900# a_5540_2580# GND sky130_fd_pr__res_xhigh_po w=350000u l=1.6e+07u
X3 GND Vb4 sky130_fd_pr__cap_mim_m3_2 l=1.58e+07u w=1.58e+07u
X4 a_1900_980# a_5540_660# GND sky130_fd_pr__res_xhigh_po w=350000u l=1.6e+07u
X5 a_1900_2260# a_5540_1940# GND sky130_fd_pr__res_xhigh_po w=350000u l=1.6e+07u
X6 a_1900_1620# a_5540_1300# GND sky130_fd_pr__res_xhigh_po w=350000u l=1.6e+07u
X7 a_1900_340# a_5540_20# GND sky130_fd_pr__res_xhigh_po w=350000u l=1.6e+07u
X8 a_1900_2900# Vb4 GND sky130_fd_pr__res_xhigh_po w=350000u l=1.6e+07u
X9 Vb4_ a_5540_20# GND sky130_fd_pr__res_xhigh_po w=350000u l=1.6e+07u
X10 Vb4_ Vb4_ GND GND sky130_fd_pr__nfet_01v8 ad=0p pd=0u as=0p ps=0u w=4e+06u l=450000u
**devattr d=D
X11 a_1900_2260# a_5540_2580# GND sky130_fd_pr__res_xhigh_po w=350000u l=1.6e+07u
X12 a_1900_1620# a_5540_1940# GND sky130_fd_pr__res_xhigh_po w=350000u l=1.6e+07u
X13 a_1900_340# a_5540_660# GND sky130_fd_pr__res_xhigh_po w=350000u l=1.6e+07u
.ends
