giljerard/tia-sscs-pico-2021/(commit log)

2021-10-22 added preliminary files
    [cmfb.sch, cmfb_half.sch, cmfb_test.sch, core.sch, core_core.sch, core_half.sch, flattened.sch, mirror_1.sch]
2021-10-22 updates and added to README
    [flattened.sch]
2021-10-22 updated layout and lvs
    [flattened_cmfb_stability.sch, flattened_core_stability.sch, top.sch]
